TWT233/lh60/docs/archive/README.md

# Archive

这里保存设计过程中的历史拷问记录和早期 ADR。它们用于追溯为什么放弃某些方案，
不作为当前设计基线。

当前结论请先读：

- `docs/current-baseline.md`
- `docs/glossary.md`
- `docs/socket-baseline.md`
- `lib/lh60-sockets/README.md`

归档文档里可能包含已被后续实测推翻的阶段性结论；若与当前基线冲突，以当前基线为准。
