TWT233/lh60/docs/archive/rshift-2.75u/README.md

# Retired RShift 2.75u Analysis

This directory preserves the superseded five-socket RShift search and its
historical verifier. Production no longer supports `r3_rshift_2.75u`; the
active four-socket contract lives in:

- `tools/lh60_design/layout.py`
- `docs/regions/rshift.json`
- `tools/verify_region_rshift.py`

Do not use the archived report as a production placement or DRC gate.
