TWT233/lh60/docs/archive/adr/0002-hotswap-conflict-zones.md

# ADR-0002：热插拔多配列的冲突区策略（PROPOSED）

- 状态：**PROPOSED**（待用户确认，未实施）
- 日期：2026-08-14
- 背景：目标"0 焊接支持多配列"；原方案为"所有键位同时预埋热插拔座，冲突区旋转避让"。本次拷问用封装几何验证了该方案。

## 关键证据（kiswitch Choc V1/V2 座，1u = 18 mm）

座子封装（`SW_Hotswap_Kailh_Choc_V1V2_Plated_1.00u`）关键尺寸（相对开关中心）：

- 铜焊盘：x ∈ [-4.775, +9.775]（Plated 版 3.85 宽；非 Plated 版 2.55 宽）
- 轴针孔（NPTH Ø3.05）：位于 (0, -5.9) 与 (5, -3.8)
- 中心孔（NPTH Ø5.05，V2 中心柱）+ 两侧 Ø1.9（V1 固定脚）
- 座体（B.Fab）约 x ∈ [-2.5, +8.3]

两个座子共存的最小中心距（含 0.2 mm 电气间隙）：

| 方向组合 | 焊盘 | 轴孔 | 座体 | 综合最小中心距 |
|---|---:|---:|---:|---:|
| 同向（正+正） | 14.55 mm | 3.05 mm | 10.8 mm | **≈14.6 mm** |
| 反向（正+倒 180°） | 7.55 mm | 13.05 mm | 16.6 mm | **≈16.6 mm** |

本设计冲突区的实际中心距：

| 冲突区 | 间距 |
|---|---:|
| 顶排 2u ↔ 分裂 1u（×2） | 9.0 mm（0.5u） |
| ANSI Enter 2.25u ↔ 分裂 Fn 1u | 11.25 mm（0.625u） |
| ANSI Enter 2.25u ↔ 分裂 Enter 1.25u | 9.0 mm |
| LShift 2.25u ↔ 分裂 Shift 1.25u | 9.0 mm |
| LShift 2.25u ↔ 分裂 Fn 1u | 11.25 mm |
| RShift 2.75u ↔ 分裂 Shift 1.75u | 9.0 mm |
| RShift 2.75u ↔ Fn 1u @14u | 15.75 mm ✅ 可行 |

旋转只有 0°/180° 合法（90° 会破坏轴针与孔位对齐），且旋转后要么焊盘重叠、要么轴孔重叠，**无法把间距拉到 ≥14.6 mm**。

另发现：旧版底排方案（6.25u 空格 ↔ 方向键版 Fn 1.25u）中心距仅 4.5 mm，**同样不可行**；新配列的单底排反而规避了该问题。

## 结论与提案

"全预埋 + 旋转"在冲突区**物理不可行**（GH60 之所以能做到，是因为焊接板只需两组小孔，无需同时放两个座子）。因此提案：

1. **冲突区（顶排右 / Enter / LShift / RShift）改为"按订单装配选择"**：同一 PCB、同一矩阵、同一固件，工厂按用户选的配列只焊对应的一组座子；用户到手仍是 0 焊接热插拔。
2. **非冲突区（字母区、底排、RShift↔Fn@14 等间距 ≥14.6 mm 的组合）全部预埋**，用户可自由插拔。
3. 冲突区在丝印/文档中明确标注"配列 A / 配列 B"，避免用户误解为可随时切换。

## 后果

- 满足"0 焊接"；"多配列"从"用户随时切换"降级为"同一 PCB 支持多配列、出厂时选择"，冲突区切换需返厂或自行补焊。
- 若用户坚持冲突区也要免焊切换，则需要：放弃分裂选项只保留大键（即退化为固定 ANSI），或寻找更小的座子/新工艺（当前无市售方案）。

## 备选（未采纳）

- 混合方案：冲突区用 GH60 式焊接焊盘，其余热插拔 —— 违反"0 焊接"。
- 每配列一块独立 PCB 变体 —— 失去"同一 PCB 多配列"意义。
