TWT233/lh60/docs/archive/grill/001-rework.md

# LH60 重盘设计 · 拷问报告 #001

> 生成：2026-08-14 · grill-with-docs 会话（grilling + domain-modeling 技能未安装，按同等工作流执行）
> 主题：从旧 v2 设计（git 历史）与新 KLE 配列出发，重新盘设计

## 1. 目标重述

- **基础目标**：60% 布局键盘，用户 0 焊接即可使用；支持多种配列与多种轴。
- **实现方法**：仿 GH60 单功能区多配列；改为热插拔；冲突用旋转封装解决。

## 2. 配列归一化（新 KLE → 坐标表）

单位 u；mm = x×18 / y×17。行内多个选项为互斥装配。

### Row 0（y=0）

| 键 | 尺寸 | x(u) | 节点 | 备注 |
|---|---:|---:|---|---|
| Esc | 1u | 0 | R1/C1 | |
| 1…0, -, =（12 键） | 1u | 1…12 | R1/C2…C13 | |
| 2u（顶排右） | 2u | 13 | R1/C14 | 与分裂右半共享 |
| Fn（分裂左） | 1u | 13 | R5/C12 | 独立 |
| Caps/Del（分裂右） | 1u | 14 | R1/C14 | 与 2u 共享 |

### Row 1（y=1）

| 键 | 尺寸 | x(u) | 节点 |
|---|---:|---:|---|
| Tab | 1.5u | 0 | R2/C1 |
| Q…P（10 键） | 1u | 1.5…10.5 | R2/C2…C11 |
| [ / ] | 1u | 11.5 / 12.5 | R2/C12 / C13 |
| \| \ | 1.5u | 13.5 | R2/C14 |

### Row 2（y=2）

| 键 | 尺寸 | x(u) | 节点 | 备注 |
|---|---:|---:|---|---|
| Backspace* | 1.75u | 0 | R3/C1 | 标签占位，物理为 Caps Lock 位 |
| A…L（9 键） | 1u | 1.75…10.75 | R3/C2…C10 | |
| ; / ' | 1u | 11.75 / 12.75 | R3/C11 / C12 | |
| Enter ANSI | 2.25u | 12.75 | R3/C13 | |
| Fn（分裂 Enter 左） | 1u | 12.75 | R3/C14 | 独立 |
| Enter 分裂 | 1.25u | 13.75 | R3/C13 | 与 ANSI 共享 |

### Row 3（y=3）

| 键 | 尺寸 | x(u) | 节点 | 备注 |
|---|---:|---:|---|---|
| Fn（分裂 LShift 左） | 1u | 0 | R4/C1 | 独立 |
| LShift / 分裂 Shift | 2.25u / 1.25u | 0 / 1 | R4/C2 | 共享 |
| Z…?（10 键） | 1u | 2.25…11.25 | R4/C3…C12 | |
| RShift / 分裂 Shift | 2.75u / 1.75u | 12.25 | R4/C13 | 共享 |
| Fn / ↑（分裂 RShift 右） | 1u | 14 | R4/C14 | 独立；旧版为 ↑，新版为 Fn |

> ⚠️ KLE 中分裂 RShift 写的是 `{x:10,w:1.75}`，按绝对坐标该行右端只到 12.75u，**疑似笔误**；按 15u 对齐应为 `{x:12.25}`。

### Row 4（y=4，单方案）

| 键 | 尺寸 | x(u) | 节点 |
|---|---:|---:|---|
| Ctrl / Win / Alt | 1.25u | 0 / 1.25 / 2.5 | R5/C1…C3 |
| Space | 2.25u | 3.75 | R5/C4 |
| Fn | 1u | 6 | R5/C5 |
| ← ↓ ↑ → | 1u | 7 / 8 / 9 / 10 | R5/C6…C9 |
| Fn / Alt / Win / Ctrl | 1u | 11 / 12 / 13 / 14 | R5/C10…C13 |

## 3. 与旧 v2（layout-v2.md）的差异

| 区域 | 旧 v2 | 新配列 | 影响 |
|---|---|---|---|
| 顶排右 | Backspace 2u / ~ + Del | 2u / Fn + Caps（几何相同） | 无几何变化，仅语义占位 |
| Enter | ANSI + ISO(1.25×2u) | ANSI + 分裂(Fn + 1.25u) | **ISO 被移除，新增分裂 Enter** |
| LShift | Fn + 1.25u 分裂 | 相同 | 无变化 |
| RShift | 1.75u + ↑ | 1.75u + Fn | 语义占位变化 |
| 底排 | 方向键版 + 标准 6.25u 版 | 仅方向键版（2.25u 空格） | **6.25u 标准空格被移除**；旧版底排存在 4.5mm 座冲突，本就不可行 |
| 矩阵 | 68 节点 / 78 座 | ≈70 节点 / ≈74 座（满矩阵） | 无空闲节点，需复核 |

## 4. 核心技术拷问：旋转能解决冲突吗？

**不能。** 详见 ADR-0002。要点：

- Choc V1/V2 座最小共存中心距 ≈14.6 mm（同向）或 16.6 mm（反向）。
- 本设计冲突区中心距 9–11.25 mm，全部低于下限；旋转 0°/180° 均无法同时满足"焊盘不短路 + 轴孔不重叠 + 座体不相撞"。
- 结论：**冲突区无法全预埋**，只能"按订单装配选择"，或放弃分裂/大键选项。

## 5. 其他风险清单

1. **"多轴"范围未定义**：Choc V1/V2（18×17，推荐）还是 MX/Choc 都要（需 19.05，且 MX 座更宽、冲突更严重，同一位置无法双座）？ADR-0001 假定 Choc 专属。
2. **定位板策略**：多配列 = 多块定位板（每配列一块）；卫星轴为 plate-mount，PCB 无封装。需确认"换配列 = 换定位板 + 移动轴体"可接受。
3. **2.25u 空格键帽**：Choc 生态里 2.25u 键帽（MBK/LDSA）可得但少见，需下单前验证；2.25u 空格需 2u plate-mount 卫星轴 + 对应定位板开槽。
4. **矩阵满负荷**：新配列 ≈70 节点 = 14×5 全用满，无空闲；若后续加功能（如旋钮、编码器）无 IO 余量（RP2040-Tiny 剩 1 GPIO）。
5. **0 焊接定义**：假设为"工厂预装配、用户插轴装帽"；换配列在冲突区需出厂选择，需在售卖/文档中说明。
6. **RP2040-Tiny FPC 分体 USB**：沿用旧设计（D+/D−、VSYS、GND、RUN、BOOT），引脚顺序待 Adapter V1.1 原理图核对。

## 6. 开放问题（待用户裁决）

| # | 问题 | 推荐 |
|---|---|---|
| Q1 | "多种轴"指 Choc V1/V2，还是包含 MX？ | Choc V1/V2（保 18×17） |
| Q2 | 冲突区接受"出厂按配列选座"吗？ | 接受（否则多配列无法热插拔） |
| Q3 | 分裂 RShift 的 `{x:10}` 是否应为 `{x:12.25}`？ | 是 |
| Q4 | ISO 是否彻底放弃？ | 放弃 |
| Q5 | 底排只保留方向键版（2.25u 空格）？ | 保留 |
| Q6 | 顶排右端保留 2u 与分裂 1u+1u 两套（出厂二选一）？ | 保留 |
| Q7 | 定位板每配列一块，可接受？ | 可接受 |
| Q8 | 2.25u 空格键帽可得性，是否确认过？ | 待验证 |

## 7. 下一步

1. 用户确认 Q1–Q8 → 更新 ADR-0002 为 ACCEPTED。
2. 出最终配列几何图（KLE gist 更新 + mm 坐标表）。
3. 建 KiCad 工程，重写 fp-lib-table / sym-lib-table。
4. 原理图（矩阵 ≈74 座 / 70 二极管 + RP2040-Tiny + USB-C/FPC）。
5. PCB 布板：非冲突区全预埋，冲突区按装配变体；DRC 清零；输出 BOM/图纸。
