TWT233/lh60/docs/archive/grill/002-switch-family.md

# LH60 拷问报告 #002：轴家族转向 + 旋转避让实测

> 生成：2026-08-14 · grill-with-docs 第二轮

## 1. 用户第二轮裁决

| # | 问题 | 裁决 |
|---|---|---|
| Q1 | 轴的范围 | **Gateron 矮轴（KS-33）为主**，Choc V1/V2 兼容"可以考虑"（待物理验证） |
| Q2 | 冲突区策略 | 待讨论：主张"旋转封装可支持" |
| Q3 | 分裂 RShift 坐标 | 不修正 `{x:10}`（有争议，见 §3） |
| Q4 | ISO Enter | 放弃 |
| Q5 | 6.25u 标准空格 | 放弃 |
| Q6 | 顶排右端 2u ↔ 分裂 | 保留两套，主张"2u 旋转 180° 焊座子" |
| Q7 | 定位板 | 本轮不考虑 |
| Q8 | 产品形态 | 只出 PCB |
| Q9 | 灯效 | 不做灯 |
| Q10 | 键帽 | 用户自行解决 |

## 2. 旋转避让实测（第二轮验证）

对两种实际座子封装做 2D 几何检查（铜焊盘间距 ≥0.2 mm；孔壁 ≥0.3 mm），
两个座子共存的最小中心距：

| 座子 | 同向 | 180° 反向 |
|---|---:|---:|
| kiswitch `SW_Hotswap_Kailh_Choc_V1V2_Plated_1.00u` | 14.76 mm | 13.22 mm |
| Kailh `CPG151101S11`（KaiHua contact，旧板用） | 16.20 mm | 12.16 mm |

当前 KLE 冲突区中心距：顶排 2u↔分裂 9.0 mm；Enter ANSI↔分裂 Fn 11.25 mm；
Enter↔分裂 Enter 9.0 mm；LShift↔分裂 Fn 11.25 mm；LShift↔分裂 Shift 9.0 mm；
RShift↔分裂 Shift 9.0 mm。

**结论：全部低于 12.16 mm 下限，任何旋转组合都无法共存。**
且孔位重叠意味着"同一 PCB 同时携带两套座子的孔"本身就不成立，
不是焊接/装配策略能绕过的。唯一可行组合：RShift(2.75u)↔Fn@14u（15.75 mm）。

因此"旋转支持"在多配列冲突区**物理不可行**；旧 lh60 为 19.05 mm 网格的在研板，
并非 DRC 验证过的先例。

## 3. 待确认：分裂 RShift 坐标

KLE 中 `["Fn",{w:1.25},"Shift",{x:10,w:1.75},"Shift","Fn"]`：
`x:10` 为绝对坐标，右组落在 10–12.75u，与主行 `M`/`<`/`>`/`?`（9.25–12.25u）重叠，
且 12.75–15u 空出。用户裁决"不修正"，理由为"这一行左边已经有分裂 LShift"。
若意图是标准 60% 分裂 RShift，应为 `{x:12.25}`（1.75u @12.25–14 + Fn @14–15）。
待下一轮澄清。

## 4. 平台转向风险

- Gateron LP（KS-33）与 Kailh Choc V1/V2 引脚布局不同，**市售双兼容座是否存在待查证**
  （调研员在途）。若不存在，"Gateron 为主 + 兼容 Choc"二者只能选一。
- Gateron LP 为 MX 轴心键帽；标准键距 19.05×19.05（板宽 285.75 mm），
  也可配 18×17 紧凑键帽（MBK 等）——键距决策待用户确认。
- 若 Gateron LP 热插拔座为纯 SMD 小焊盘（Keychron 式），冲突区可能不再受限，
  "一块 PCB 全预埋多配列"重新可行；此假设待座子几何事实确认。

## 5. 已定（不再回滚）

- 放弃 ISO Enter、放弃 6.25u 标准空格。
- 只出 PCB；定位板暂缓；无灯效；键帽由用户自选。
