TWT233/lh60/docs/O1CN01bK2mBI1wGI35HnOHL_!!51786280.jpg

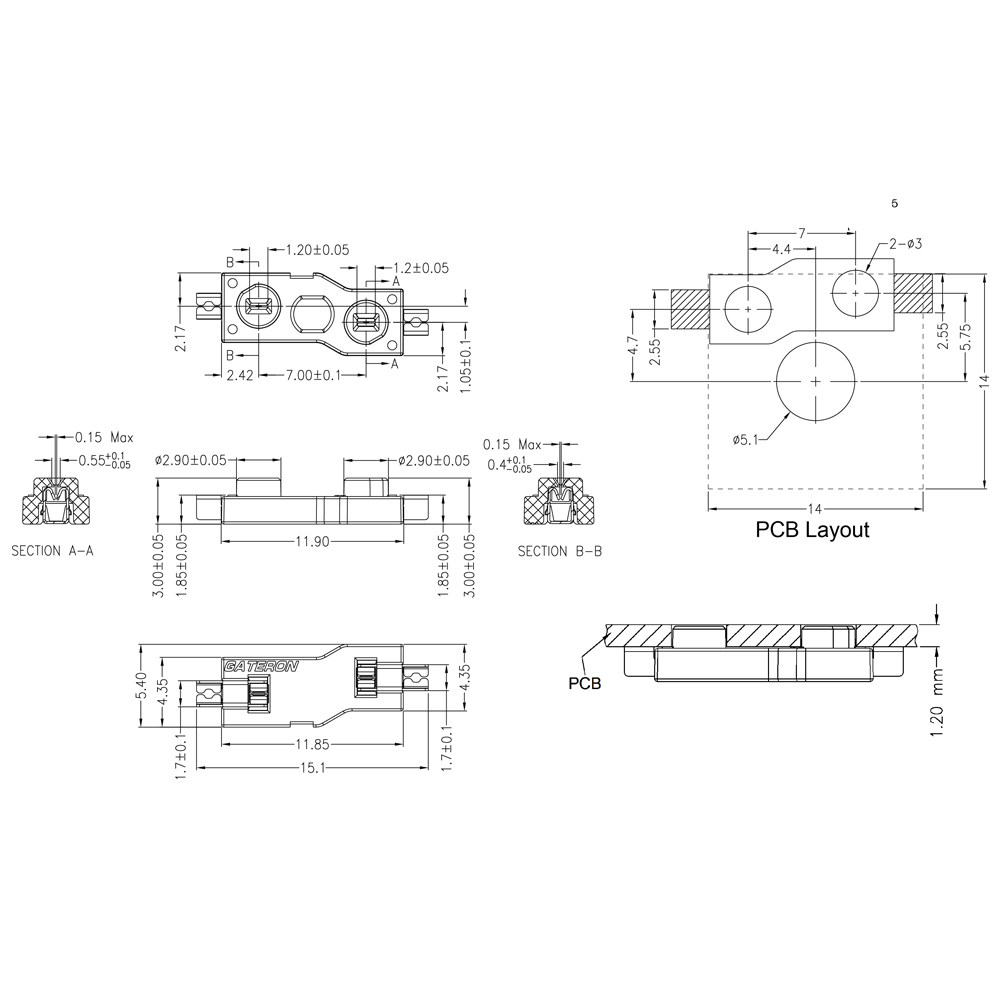
docs/O1CN01bK2mBI1wGI35HnOHL_!!51786280.jpg
