TWT233/lh60/docs/O1CN01MdCCDh1wGI9zMBahx_!!51786280.jpg

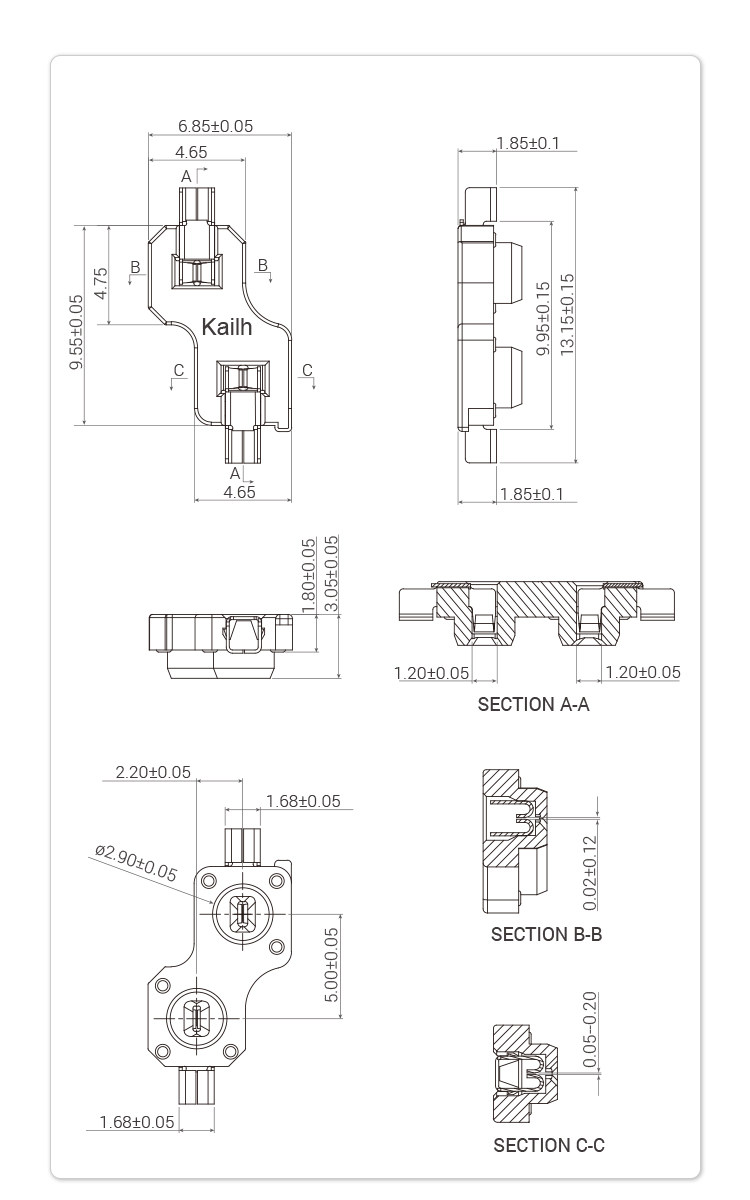
docs/O1CN01MdCCDh1wGI9zMBahx_!!51786280.jpg
