TWT233/lh60/docs/archive/grill/003-test-bench.md

# LH60 拷问报告 #003：测试工程 + 键距落定

> 生成：2026-08-14 · grill-with-docs 第三轮

## 1. 本轮裁决

| # | 问题 | 裁决 |
|---|---|---|
| P1 | 轴家族 | **待用户上手测试后定**（已交付测试 KiCad 工程） |
| P2 | 键距 | **19.05×19.05，MX 键帽生态**（15u = 285.75 mm） |
| P3 | 分裂 RShift 坐标 | 用户解释 `{x:10}` 系"左边有 2.25 分裂 LShift"所致；语义存疑，见 §3 |
| P4 | 主控/USB | **RP2040-Tiny + 8 针 FPC 分体引出**（沿用 ADR-0001）；USB-C 口位置未定 |

## 2. 测试工程（已交付，已提交推送）

路径：`test/lh60-test.kicad_pcb`（生成器 `test/generate_test_pcb.py`，可复现）。

内容（全部 19.05 mm 网格、两种真实座子封装内嵌：kiswitch Choc V1/V2 Plated 与
Kailh CPG151101S11）：

1. 四个冲突区（顶排右 / Enter / LShift / RShift）各两组尝试：全 0° 与"大键 180°"。
2. 基准区：两种座子在"最小可共存距离 +0.05 mm"下的参考对，DRC 应干净。
3. 分裂 RShift 歧义区：KLE 原样 `{x:10}` 与右对齐 `{x:12.25}` 两种画法对照。
4. 15u × 5u 网格 + 可自由复制的座子 palette。

KiCad 10 CLI 实测 DRC（min clearance 0.2 / hole-to-hole 0.25）：

| 违规类型 | 数量 | 含义 |
|---|---:|---|
| solder_mask_bridge | 44 | 焊盘过近，阻焊桥缺失 |
| shorting_items | 22 | 不同网络铜焊盘直接重叠（短路） |
| hole_to_hole | 12 | 孔壁重叠/孔距不足 |
| hole_clearance | 9 | 孔与铜间距不足 |
| mirrored_text（警告） | 5 | KaiHua 封装文字镜像，装饰性 |

**结论再次确认**：冲突区（9.53 / 11.91 mm）无论同向还是 180°，DRC 全部报错；
基准区干净。即"旋转 180°"无法让 2u 与分裂座共存于同一 PCB。

## 3. 分裂 RShift 坐标（待用户在看测试图后确认）

KLE `{x:10}` 在绝对坐标语义下右组落在 10–12.75u，与主行 `M < > ?`（9.25–12.25u）重叠。
用户的解释（"左边有 2.25 分裂 LShift"）若指"左组 2.25u + 10 个字母 = 12.25u"，则
正确坐标应为 `x:12.25`。测试工程 E 区把两种画法并排画出，供直观对照；KLE 语义为绝对坐标。

## 4. 下一步

1. 用户上手测试工程；若确认旋转无解 → 冲突区策略收口（Gateron LP 纯 SMD 座可行则全预埋，
   Choc 则只能放弃分裂或分板）。
2. 调研员带回 Gateron LP 座子几何后，把其封装加入测试工程，验证 9 mm 共存假设。
3. 定 USB-C 口位置与板外形 → 建正式 KiCad 工程（原理图 + PCB）。
