TWT233/lh60/lh60.kicad_pcb

## KiCad design lh60.kicad_pcb (2026-08-28)

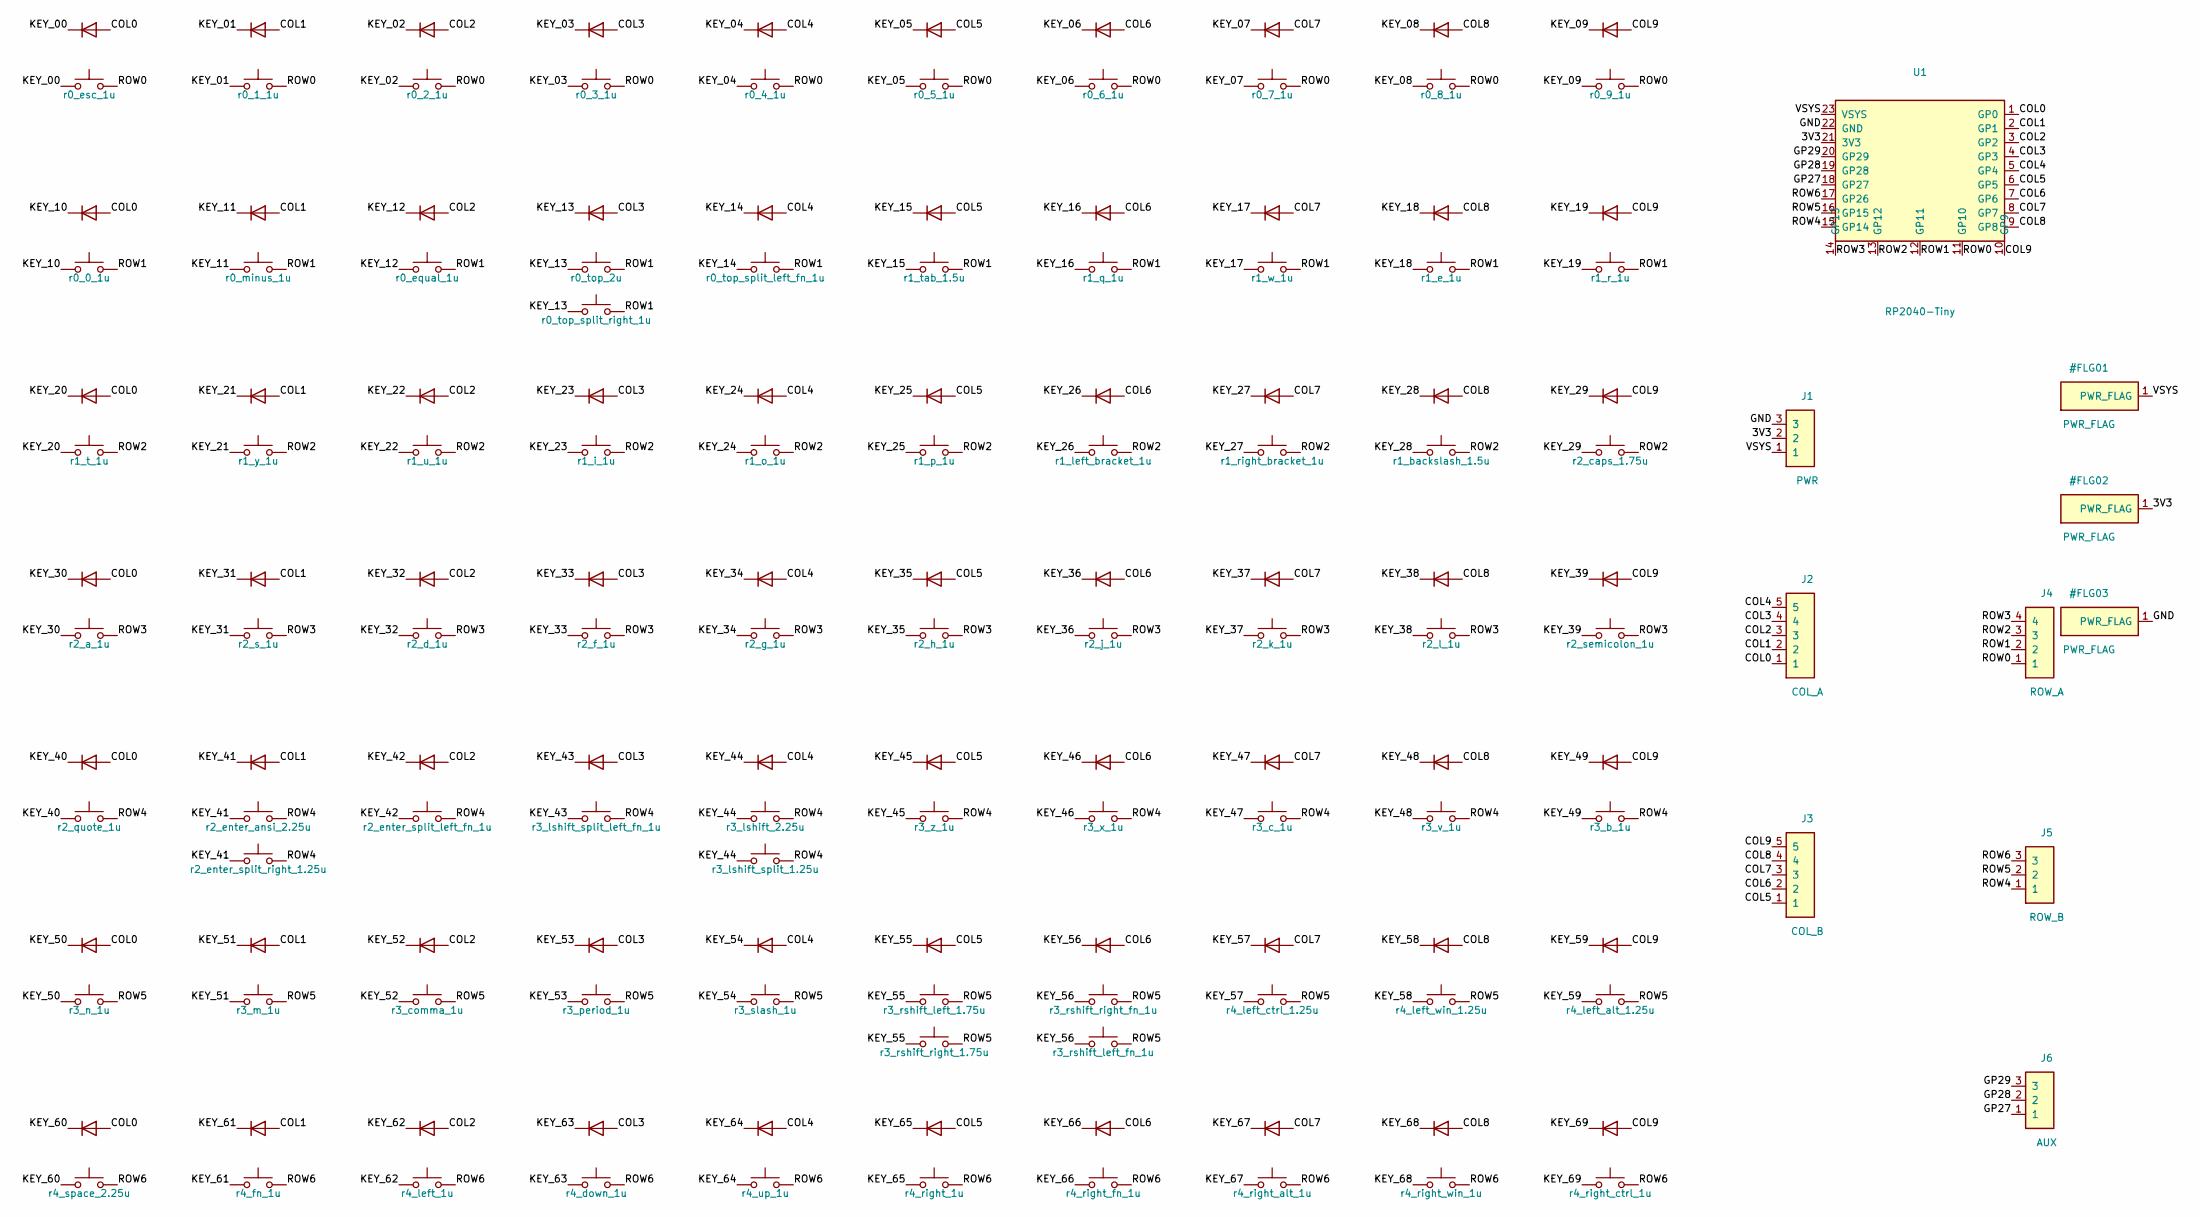
[picture p3: schematic lh60.kicad_sch]

Parts:
D1, D2, D3, D4, D5, D6, D7, D8, D9, D10, D11, D12, D13, D14, D15, D16, D17, D18, D19, D20, D21, D22, D23, D24, D25, D26, D27, D28, D29, D30, D31, D32, D33, D34, D35, D36, D37, D38, D39, D40, D41, D42, D43, D44, D45, D46, D47, D48, D49, D50, D51, D52, D53, D54, D55, D56, D57, D58, D59, D60, D61, D62, D63, D64, D65, D66, D67, D68, D69, D70: 1N4148WS; D_SOD-323_Bottom
J1: PWR; PinHeader_1x03_P2.54mm_Vertical
J2: COL_A; PinHeader_1x05_P2.54mm_Vertical
J3: COL_B; PinHeader_1x05_P2.54mm_Vertical
J4: ROW_A; PinHeader_1x04_P2.54mm_Vertical
J5: ROW_B; PinHeader_1x03_P2.54mm_Vertical
J6: AUX; PinHeader_1x03_P2.54mm_Vertical
SW1: r0_esc_1u; Gateron-LP-or-ChocV1-Hotswap-Socket-1U
SW2: r0_1_1u; Gateron-LP-or-ChocV1-Hotswap-Socket-1U
SW3: r0_2_1u; Gateron-LP-or-ChocV1-Hotswap-Socket-1U
SW4: r0_3_1u; Gateron-LP-or-ChocV1-Hotswap-Socket-1U
SW5: r0_4_1u; Gateron-LP-or-ChocV1-Hotswap-Socket-1U
SW6: r0_5_1u; Gateron-LP-or-ChocV1-Hotswap-Socket-1U
SW7: r0_6_1u; Gateron-LP-or-ChocV1-Hotswap-Socket-1U
SW8: r0_7_1u; Gateron-LP-or-ChocV1-Hotswap-Socket-1U
SW9: r0_8_1u; Gateron-LP-or-ChocV1-Hotswap-Socket-1U
SW10: r0_9_1u; Gateron-LP-or-ChocV1-Hotswap-Socket-1U
SW11: r0_0_1u; Gateron-LP-or-ChocV1-Hotswap-Socket-1U
SW12: r0_minus_1u; Gateron-LP-or-ChocV1-Hotswap-Socket-1U
SW13: r0_equal_1u; Gateron-LP-or-ChocV1-Hotswap-Socket-1U
SW14: r0_top_2u; Gateron-LP-Hotswap-Socket-2U
SW15: r0_top_split_left_fn_1u; Gateron-LP-Hotswap-Socket-1U
SW16: r0_top_split_right_1u; Gateron-LP-Hotswap-Socket-1U
SW17: r1_tab_1.5u; Gateron-LP-or-ChocV1-Hotswap-Socket-1.5U
SW18: r1_q_1u; Gateron-LP-or-ChocV1-Hotswap-Socket-1U
SW19: r1_w_1u; Gateron-LP-or-ChocV1-Hotswap-Socket-1U
SW20: r1_e_1u; Gateron-LP-or-ChocV1-Hotswap-Socket-1U
SW21: r1_r_1u; Gateron-LP-or-ChocV1-Hotswap-Socket-1U
SW22: r1_t_1u; Gateron-LP-or-ChocV1-Hotswap-Socket-1U
SW23: r1_y_1u; Gateron-LP-or-ChocV1-Hotswap-Socket-1U
SW24: r1_u_1u; Gateron-LP-or-ChocV1-Hotswap-Socket-1U
SW25: r1_i_1u; Gateron-LP-or-ChocV1-Hotswap-Socket-1U
SW26: r1_o_1u; Gateron-LP-or-ChocV1-Hotswap-Socket-1U
SW27: r1_p_1u; Gateron-LP-or-ChocV1-Hotswap-Socket-1U
SW28: r1_left_bracket_1u; Gateron-LP-or-ChocV1-Hotswap-Socket-1U
SW29: r1_right_bracket_1u; Gateron-LP-or-ChocV1-Hotswap-Socket-1U
SW30: r1_backslash_1.5u; Gateron-LP-or-ChocV1-Hotswap-Socket-1.5U
SW31: r2_caps_1.75u; Gateron-LP-or-ChocV1-Hotswap-Socket-1.75U
SW32: r2_a_1u; Gateron-LP-or-ChocV1-Hotswap-Socket-1U
SW33: r2_s_1u; Gateron-LP-or-ChocV1-Hotswap-Socket-1U
SW34: r2_d_1u; Gateron-LP-or-ChocV1-Hotswap-Socket-1U
SW35: r2_f_1u; Gateron-LP-or-ChocV1-Hotswap-Socket-1U
SW36: r2_g_1u; Gateron-LP-or-ChocV1-Hotswap-Socket-1U
SW37: r2_h_1u; Gateron-LP-or-ChocV1-Hotswap-Socket-1U
SW38: r2_j_1u; Gateron-LP-or-ChocV1-Hotswap-Socket-1U
SW39: r2_k_1u; Gateron-LP-or-ChocV1-Hotswap-Socket-1U
SW40: r2_l_1u; Gateron-LP-or-ChocV1-Hotswap-Socket-1U
SW41: r2_semicolon_1u; Gateron-LP-or-ChocV1-Hotswap-Socket-1U
SW42: r2_quote_1u; Gateron-LP-or-ChocV1-Hotswap-Socket-1U
SW43: r2_enter_ansi_2.25u; Gateron-LP-Hotswap-Socket-2.25U
SW44: r2_enter_split_left_fn_1u; Gateron-LP-Hotswap-Socket-1U
SW45: r2_enter_split_right_1.25u; Gateron-LP-Hotswap-Socket-1.25U
SW46: r3_lshift_split_left_fn_1u; Gateron-LP-Hotswap-Socket-1U
SW47: r3_lshift_2.25u; Gateron-LP-Hotswap-Socket-2.25U
SW48: r3_lshift_split_1.25u; Gateron-LP-Hotswap-Socket-1.25U
SW49: r3_z_1u; Gateron-LP-or-ChocV1-Hotswap-Socket-1U
SW50: r3_x_1u; Gateron-LP-or-ChocV1-Hotswap-Socket-1U
SW51: r3_c_1u; Gateron-LP-or-ChocV1-Hotswap-Socket-1U
SW52: r3_v_1u; Gateron-LP-or-ChocV1-Hotswap-Socket-1U
SW53: r3_b_1u; Gateron-LP-or-ChocV1-Hotswap-Socket-1U
SW54: r3_n_1u; Gateron-LP-or-ChocV1-Hotswap-Socket-1U
SW55: r3_m_1u; Gateron-LP-or-ChocV1-Hotswap-Socket-1U
SW56: r3_comma_1u; Gateron-LP-or-ChocV1-Hotswap-Socket-1U
SW57: r3_period_1u; Gateron-LP-or-ChocV1-Hotswap-Socket-1U
SW58: r3_slash_1u; Gateron-LP-or-ChocV1-Hotswap-Socket-1U
SW60: r3_rshift_left_1.75u; Gateron-LP-Hotswap-Socket-1.75U
SW61: r3_rshift_right_fn_1u; Gateron-LP-Hotswap-Socket-1U
SW62: r3_rshift_left_fn_1u; Gateron-LP-Hotswap-Socket-1U
SW63: r3_rshift_right_1.75u; Gateron-LP-Hotswap-Socket-1.75U
SW64: r4_left_ctrl_1.25u; Gateron-LP-or-ChocV1-Hotswap-Socket-1.25U
SW65: r4_left_win_1.25u; Gateron-LP-or-ChocV1-Hotswap-Socket-1.25U
SW66: r4_left_alt_1.25u; Gateron-LP-or-ChocV1-Hotswap-Socket-1.25U
SW67: r4_space_2.25u; Gateron-LP-or-ChocV1-Hotswap-Socket-2.25U
SW68: r4_fn_1u; Gateron-LP-or-ChocV1-Hotswap-Socket-1U
SW69: r4_left_1u; Gateron-LP-or-ChocV1-Hotswap-Socket-1U
SW70: r4_down_1u; Gateron-LP-or-ChocV1-Hotswap-Socket-1U
SW71: r4_up_1u; Gateron-LP-or-ChocV1-Hotswap-Socket-1U
SW72: r4_right_1u; Gateron-LP-or-ChocV1-Hotswap-Socket-1U
SW73: r4_right_fn_1u; Gateron-LP-or-ChocV1-Hotswap-Socket-1U
SW74: r4_right_alt_1u; Gateron-LP-or-ChocV1-Hotswap-Socket-1U
SW75: r4_right_win_1u; Gateron-LP-or-ChocV1-Hotswap-Socket-1U
SW76: r4_right_ctrl_1u; Gateron-LP-or-ChocV1-Hotswap-Socket-1U
U1: RP2040-Tiny; MCU_RP2040-Tiny_SMD

Connections:
/3V3: J1.2, U1.21 (3V3)
/COL0: D1.2 (A), D11.2 (A), D21.2 (A), D31.2 (A), D41.2 (A), D51.2 (A), D61.2 (A), J2.1, U1.1 (GP0)
/COL1: D2.2 (A), D12.2 (A), D22.2 (A), D32.2 (A), D42.2 (A), D52.2 (A), D62.2 (A), J2.2, U1.2 (GP1)
/COL2: D3.2 (A), D13.2 (A), D23.2 (A), D33.2 (A), D43.2 (A), D53.2 (A), D63.2 (A), J2.3, U1.3 (GP2)
/COL3: D4.2 (A), D14.2 (A), D24.2 (A), D34.2 (A), D44.2 (A), D54.2 (A), D64.2 (A), J2.4, U1.4 (GP3)
/COL4: D5.2 (A), D15.2 (A), D25.2 (A), D35.2 (A), D45.2 (A), D55.2 (A), D65.2 (A), J2.5, U1.5 (GP4)
/COL5: D6.2 (A), D16.2 (A), D26.2 (A), D36.2 (A), D46.2 (A), D56.2 (A), D66.2 (A), J3.1, U1.6 (GP5)
/COL6: D7.2 (A), D17.2 (A), D27.2 (A), D37.2 (A), D47.2 (A), D57.2 (A), D67.2 (A), J3.2, U1.7 (GP6)
/COL7: D8.2 (A), D18.2 (A), D28.2 (A), D38.2 (A), D48.2 (A), D58.2 (A), D68.2 (A), J3.3, U1.8 (GP7)
/COL8: D9.2 (A), D19.2 (A), D29.2 (A), D39.2 (A), D49.2 (A), D59.2 (A), D69.2 (A), J3.4, U1.9 (GP8)
/COL9: D10.2 (A), D20.2 (A), D30.2 (A), D40.2 (A), D50.2 (A), D60.2 (A), D70.2 (A), J3.5, U1.10 (GP9)
/GND: J1.3, U1.22 (GND)
/GP27: J6.1, U1.18 (GP27)
/GP28: J6.2, U1.19 (GP28)
/GP29: J6.3, U1.20 (GP29)
/KEY_00: D1.1 (K), SW1.1
/KEY_01: D2.1 (K), SW2.1
/KEY_02: D3.1 (K), SW3.1
/KEY_03: D4.1 (K), SW4.1
/KEY_04: D5.1 (K), SW5.1
/KEY_05: D6.1 (K), SW6.1
/KEY_06: D7.1 (K), SW7.1
/KEY_07: D8.1 (K), SW8.1
/KEY_08: D9.1 (K), SW9.1
/KEY_09: D10.1 (K), SW10.1
/KEY_10: D11.1 (K), SW11.1
/KEY_11: D12.1 (K), SW12.1
/KEY_12: D13.1 (K), SW13.1
/KEY_13: D14.1 (K), SW14.1, SW16.1
/KEY_14: D15.1 (K), SW15.1
/KEY_15: D16.1 (K), SW17.1
/KEY_16: D17.1 (K), SW18.1
/KEY_17: D18.1 (K), SW19.1
/KEY_18: D19.1 (K), SW20.1
/KEY_19: D20.1 (K), SW21.1
/KEY_20: D21.1 (K), SW22.1
/KEY_21: D22.1 (K), SW23.1
/KEY_22: D23.1 (K), SW24.1
/KEY_23: D24.1 (K), SW25.1
/KEY_24: D25.1 (K), SW26.1
/KEY_25: D26.1 (K), SW27.1
/KEY_26: D27.1 (K), SW28.1
/KEY_27: D28.1 (K), SW29.1
/KEY_28: D29.1 (K), SW30.1
/KEY_29: D30.1 (K), SW31.1
/KEY_30: D31.1 (K), SW32.1
/KEY_31: D32.1 (K), SW33.1
/KEY_32: D33.1 (K), SW34.1
/KEY_33: D34.1 (K), SW35.1
/KEY_34: D35.1 (K), SW36.1
/KEY_35: D36.1 (K), SW37.1
/KEY_36: D37.1 (K), SW38.1
/KEY_37: D38.1 (K), SW39.1
/KEY_38: D39.1 (K), SW40.1
/KEY_39: D40.1 (K), SW41.1
/KEY_40: D41.1 (K), SW42.1
/KEY_41: D42.1 (K), SW43.1, SW45.1
/KEY_42: D43.1 (K), SW44.1
/KEY_43: D44.1 (K), SW46.1
/KEY_44: D45.1 (K), SW47.1, SW48.1
/KEY_45: D46.1 (K), SW49.1
/KEY_46: D47.1 (K), SW50.1
/KEY_47: D48.1 (K), SW51.1
/KEY_48: D49.1 (K), SW52.1
/KEY_49: D50.1 (K), SW53.1
/KEY_50: D51.1 (K), SW54.1
/KEY_51: D52.1 (K), SW55.1
/KEY_52: D53.1 (K), SW56.1
/KEY_53: D54.1 (K), SW57.1
/KEY_54: D55.1 (K), SW58.1
/KEY_55: D56.1 (K), SW60.1, SW63.1
/KEY_56: D57.1 (K), SW61.1, SW62.1
/KEY_57: D58.1 (K), SW64.1
/KEY_58: D59.1 (K), SW65.1
/KEY_59: D60.1 (K), SW66.1
/KEY_60: D61.1 (K), SW67.1
/KEY_61: D62.1 (K), SW68.1
/KEY_62: D63.1 (K), SW69.1
/KEY_63: D64.1 (K), SW70.1
/KEY_64: D65.1 (K), SW71.1
/KEY_65: D66.1 (K), SW72.1
/KEY_66: D67.1 (K), SW73.1
/KEY_67: D68.1 (K), SW74.1
/KEY_68: D69.1 (K), SW75.1
/KEY_69: D70.1 (K), SW76.1
/ROW0: J4.1, SW1.2, SW2.2, SW3.2, SW4.2, SW5.2, SW6.2, SW7.2, SW8.2, SW9.2, SW10.2, U1.11 (GP10)
/ROW1: J4.2, SW11.2, SW12.2, SW13.2, SW14.2, SW15.2, SW16.2, SW17.2, SW18.2, SW19.2, SW20.2, SW21.2, U1.12 (GP11)
/ROW2: J4.3, SW22.2, SW23.2, SW24.2, SW25.2, SW26.2, SW27.2, SW28.2, SW29.2, SW30.2, SW31.2, U1.13 (GP12)
/ROW3: J4.4, SW32.2, SW33.2, SW34.2, SW35.2, SW36.2, SW37.2, SW38.2, SW39.2, SW40.2, SW41.2, U1.14 (GP13)
/ROW4: J5.1, SW42.2, SW43.2, SW44.2, SW45.2, SW46.2, SW47.2, SW48.2, SW49.2, SW50.2, SW51.2, SW52.2, SW53.2, U1.15 (GP14)
/ROW5: J5.2, SW54.2, SW55.2, SW56.2, SW57.2, SW58.2, SW60.2, SW61.2, SW62.2, SW63.2, SW64.2, SW65.2, SW66.2, U1.16 (GP15)
/ROW6: J5.3, SW67.2, SW68.2, SW69.2, SW70.2, SW71.2, SW72.2, SW73.2, SW74.2, SW75.2, SW76.2, U1.17 (GP26)
/VSYS: J1.1, U1.23 (VSYS)

Board: 2 copper layers, 152 parts (6 on the bottom side), 93 nets, no tracks yet.
