TWT233/lh60/(commit log)

2022-03-10 feat: init
    [lh60.kicad_pcb, lh60.sch]
2022-03-10 chore: trunk commit
    [lh60.sch, matrix.sch]
2022-03-25 20220325 atmega->stm32
    [lh60.kicad_sch]
2022-03-25 sch fin
    [lh60.kicad_pcb, lh60.kicad_sch, matrix.kicad_sch]
2022-03-26 20220326 pcb init
    [lh60.kicad_pcb, lh60.kicad_sch, matrix.kicad_sch]
2022-03-26 20220326 pcb: keycap mount
    [lh60.kicad_pcb, lh60.kicad_sch, matrix.kicad_sch]
2022-03-26 20220326 fin
    [lh60.kicad_pcb, lh60.kicad_sch, matrix.kicad_sch]
2022-03-29 20220329 finish pcb
2022-04-01 20220401 sch 2.0
    [lh60.kicad_sch]
2023-08-19 alter usbc to jump connecter
    [lh60.kicad_sch, matrix.kicad_sch]
2023-08-20 finish pcb v2
    [lh60.kicad_pcb, lh60.kicad_sch]
2023-08-20 fix: hole colli
    [lh60.kicad_pcb]
2026-08-13 chore: 忽略 .worktrees 目录
2026-08-13 lib: 引入社区键盘库（kiswitch 开关封装 + ai03 Type-C/杂项封装）
2026-08-13 docs: v2 配列/矩阵规格（18x17 Choc V1V2 热插拔）
2026-08-13 docs: 沉淀设计决策与调研笔记
2026-08-13 chore: 清空旧 lh60 设计文件，分支从头开始
    [lh60.kicad_pcb, lh60.kicad_sch, lh60.sch, matrix.kicad_sch, matrix.sch]
2026-08-14 chore: 清空 docs 与键盘库，工作树归零，从头设计
2026-08-14 docs: 重盘设计拷问报告与 ADR（含热插拔冲突区几何验证）
2026-08-14 docs: 记录第二轮裁决与旋转避让实测下限
2026-08-14 test: 新增座子共存测试工程与第三轮拷问记录
    [lh60-test.kicad_pcb]
2026-08-14 chore: 忽略 __pycache__ 并移除误提交的字节码
2026-08-14 lib: 加入 ai03 MX_V2 Gateron KS33/Choc V2 热插拔封装库并注册到测试工程
2026-08-14 lib: 加入 siderakb 键盘开关封装库（Gateron LP/Choc/MX 热插拔）并注册到测试工程
2026-08-14 docs: 记录第四轮 RShift 三方案共存实测与座子几何差异
2026-08-14 lib: 提取 beekeeb 量产纯座子几何并注册 lh60_sockets 库（Gateron LP 热插拔）
2026-08-14 lib: 新增 Gateron LP 各U数辅助封装与 Gateron/ChocV1 双座封装
2026-08-14 lib: 修正 courtyard 为量产方框并验证保留镀铜不可行
2026-08-14 docs: 修正镀铜结论——保留电气孔实测可行，仅一处0.07mm制造紧点
2026-08-14 lib: 以 siderakb PTH 重建 lh60_sockets（U线框+清理courtyard/F.Fab，1U双兼容）
2026-08-14 docs: update socket compatibility baseline
    Record the current PTH-based Gateron/Choc V1 socket baseline, the Choc V2 exclusion, and the evidence required before promising dual-socket no-solder switch swapping.
2026-08-14 docs: separate current baseline from archive
    Move superseded design notes into docs/archive and add a concise current-baseline entrypoint for the active LH60 design decisions.
2026-08-15 docs: 添加 socket 参考图片
2026-08-15 docs: define socket bottom courtyard geometry
    Specify the source-dimension-based B.CrtYd rectangles for the Gateron LP socket family and the Gateron/Choc V1 dual-socket footprint.
2026-08-15 docs: refine socket courtyard to true outline
    Replace bounding-box courtyards with source-geometry unions that preserve socket recesses, arcs, and terminal extents.
2026-08-15 docs: plan socket library hardening
2026-08-15 test: add socket library regression contract
2026-08-15 feat(lib): add socket assembly geometry
2026-08-15 feat(lib): harden socket library metadata
2026-08-15 test: add reproducible socket coupons
    [socket-clean.kicad_pcb, socket-clean.kicad_sch, socket-conflicts.kicad_pcb, socket-conflicts.kicad_sch]
2026-08-15 chore: remove disposable kicad tests
    [lh60-test.kicad_pcb, socket-clean.kicad_pcb, socket-clean.kicad_sch, socket-conflicts.kicad_pcb, socket-conflicts.kicad_sch]
2026-08-15 feat(lib): add complete socket families
2026-08-15 docs: freeze current production layout
2026-08-15 feat(project): create production kicad skeleton
    [lh60.kicad_pcb, lh60.kicad_sch]
2026-08-15 feat(lib): add production schematic primitives
2026-08-15 feat(sch): add production keyboard matrix
    [lh60.kicad_sch]
2026-08-16 feat(pcb): sync from sch
    [lh60.kicad_pcb]
2026-08-16 chore(kicad): save pro
2026-08-16 feat(pcb): place production sockets
    [lh60.kicad_pcb]
2026-08-16 refactor(pcb): review
    [lh60.kicad_pcb]
2026-08-16 docs(pcb): preserve reviewed socket rotations
2026-08-16 fix(lib): exclude switch stems from courtyards
2026-08-16 refactor(pcb): sync & remove RShift
    [lh60.kicad_pcb]
2026-08-16 refactor(layout): retire RShift 2.75u option
    Remove the retired SW59 schematic path while preserving later switch references, refresh production region reports, and update layout documentation and verification gates for the 75-socket contract.
    [lh60.kicad_sch]
2026-08-16 refactor(pcb): refresh placed socket footprints
    [lh60.kicad_pcb]
2026-08-16 docs(schematic): plan default symbol migration
    Define the standard switch and diode symbol contract, Konnect-only migration path, and verification boundaries.
2026-08-16 refactor(schematic): use default switch and diode symbols
    Replace all placed switches with Switch:SW_Push and all matrix diodes with Device:D while preserving references, values, footprints, placement, and connectivity. Remove the retired project-local symbol definitions and keep support symbols and custom footprints in lh60-core.
    [lh60.kicad_sch]
2026-08-18 docs(schematic): design grouped debug headers
    Define six grouped 2.54 mm debug headers, A3 schematic reflow, field visibility behavior, project-local connector geometry, and PCB placement-only verification boundaries.
2026-08-18 docs: plan grouped debug connector implementation
    Define the cross-repository Konnect capability work, isolated LH60 TDD units, candidate-first schematic rebuild, guarded PCB synchronization, and deterministic bottom-side placement verification.
2026-08-18 test: split schematic and core library contracts
2026-08-18 feat(lib): add grouped debug pin headers
2026-08-18 test(lib): lock connector apply payloads
2026-08-18 feat(schematic): define grouped connector layout
2026-08-18 test(schematic): lock A3 display contract
2026-08-18 fix(lib): separate RP2040 schematic fields
2026-08-18 feat(schematic): add A3 convergence checks
2026-08-18 fix(schematic): improve candidate label readability
2026-08-18 fix(schematic): gate production convergence
2026-08-18 fix(schematic): harden production acceptance
2026-08-18 fix(schematic): harden production acceptance evidence
2026-08-18 fix(schematic): use candidate dir for symbol verification
2026-08-18 fix(schematic): align acceptance schema gate
2026-08-18 refactor(schematic): group debug headers on A3
    [lh60.kicad_sch]
2026-08-18 feat(pcb): add guarded debug-header synchronization
2026-08-18 fix(pcb): preserve hierarchical debug net names
2026-08-18 test(pcb): capture debug-header sync baseline
2026-08-20 feat(schematic): model non-board power flags
2026-08-20 fix(schematic): verify narrow flag migration
2026-08-20 fix(schematic): query component identities exactly
2026-08-20 fix(schematic): fingerprint every component identity
2026-08-20 fix(schematic): derive migration inventory lazily
2026-08-20 fix(schematic): exclude power flags from board sync
    [lh60.kicad_sch]
2026-08-20 fix(pcb): accept migrated schematic baseline
2026-08-20 fix(pcb): normalize root sync net names
2026-08-20 fix(pcb): rebind recreated schematic identities
2026-08-20 test(pcb): refresh debug connector baseline
2026-08-20 fix(pcb): gate connector staging before save
2026-08-20 fix(pcb): bind save gate to final inventory
2026-08-20 test(pcb): refresh guarded sync baseline
2026-08-20 refactor(pcb): replace test pads with debug headers
    [lh60.kicad_pcb]
2026-08-20 test(pcb): isolate guarded sync fixtures
2026-08-20 feat(pcb): freeze grouped header placement
2026-08-20 fix(connector): clear silkscreen from header pads
2026-08-20 test(connector): normalize live silk readback
2026-08-20 fix(connector): regenerate clear header silk
2026-08-20 feat(pcb): place grouped debug headers
    [lh60.kicad_pcb]
2026-08-20 test(pcb): add live acceptance checks
2026-08-20 fix(pcb): match live drc and csv contracts
2026-08-20 fix(pcb): accept real footprint graphics schema
2026-08-20 docs(report): capture debug connector placement evidence
2026-08-20 docs(report): tighten placement rerun contract
2026-08-20 docs(report): tighten toolchain dependency note
2026-08-20 fix(schematic): omit absent standard-symbol fields
2026-08-20 test(schematic): migrate preflight to L7 production
    Task: /root/r5_presave_fixture_fix
2026-08-20 test(pcb): prove final flip result contract
    Task: /root/final_flip_report_fix
2026-08-20 test(pcb): close placement provenance
    Task: /root/final_placement_provenance_fix
2026-08-20 fix(pcb): gate exact connector ratsnest
2026-08-20 feat(pcb): apply connector poses atomically
    Task: /root/lh60_atomic_pose_consumer_takeover
2026-08-21 fix(pcb): reject malformed live poses
2026-08-29 docs: define FFC connector clearance rule
2026-08-29 feat: define passive FFC schematic migration
2026-08-29 fix: support positional schematic label deletion
2026-08-29 fix: backfill schematic no-connect count
2026-08-29 fix: accept connected pin-end label diagnostics
2026-08-29 fix: apply passive schematic presentation
2026-08-29 test: record task 3 visual evidence
    [lh60-candidate.kicad_pcb, lh60-candidate.kicad_sch]
2026-08-29 feat: migrate main schematic to passive ffc
    [lh60.kicad_sch]
2026-08-29 chore: untrack task 3 generated evidence
    [lh60-candidate.kicad_pcb, lh60-candidate.kicad_sch]
2026-08-29 docs: narrow design to passive FFC board
2026-08-29 Split passive PCB candidate workflow into phases
